m-guihard/relativeGPS/Components/rylr998/RYLR998.stp

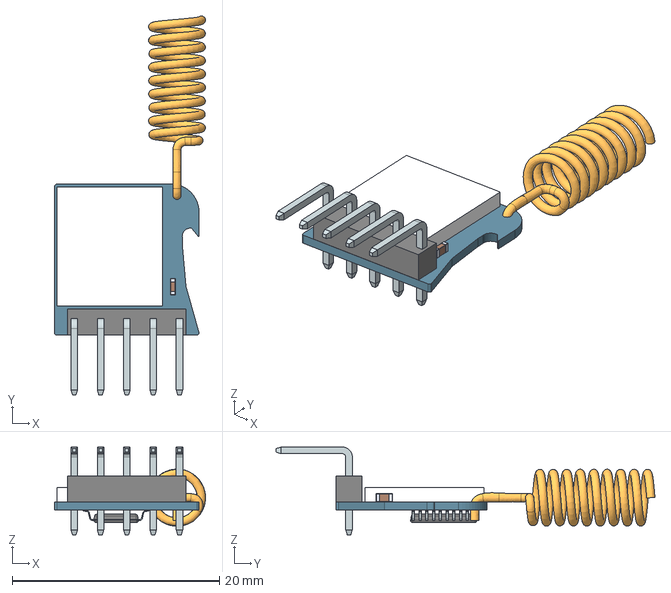
[picture p1: CAD file, 2024-04-07]
Components/rylr998/RYLR998.stp
14.6 x 36.6 x 8.49 mm
