m-guihard/relativeGPS/PCB/relativeGPS.kicad_pcb

## KiCad design PCB/relativeGPS.kicad_pcb (2025-03-02)

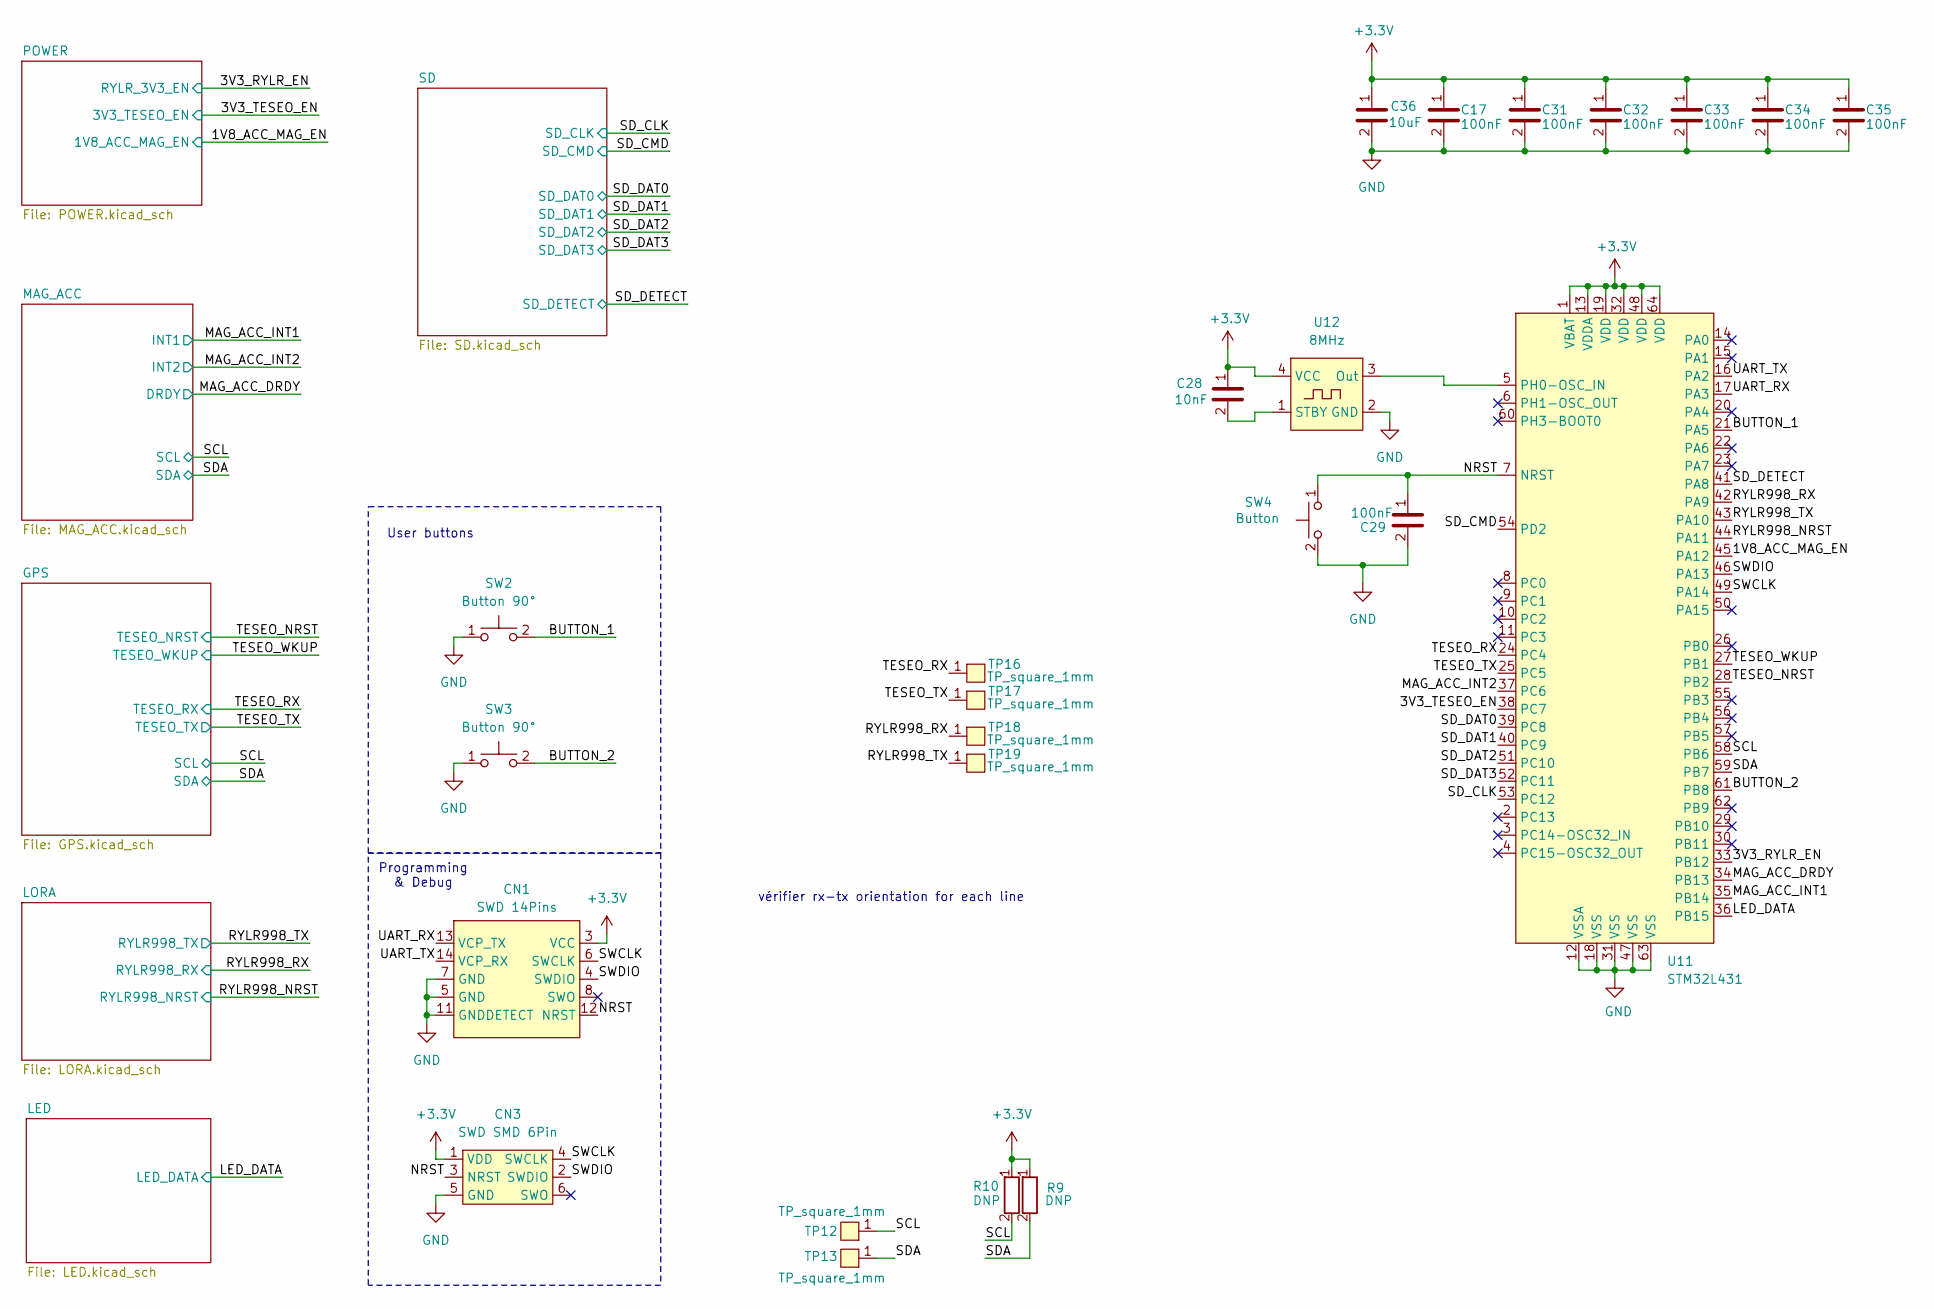
[picture p2: schematic relativeGPS.kicad_sch]

Parts:
C17, C29, C31, C32, C33, C34, C35: C_100nF_50V_10%_X7R_0402_H0.55; C_0402_H0.55; Manufacturer P/N GRM155R71H104KE14J; Digikey P/N 490-13342-1-ND
C28: C_10nF_50V_10%_X7R_0402_H0.55; C_0402_H0.55; Manufacturer P/N CGA2B3X7R1H103K050BE; Digikey P/N 445-173650-1-ND
C36: C_10uF_10V_20%_X5R_0402_H0.55; C_0402_H0.55; Manufacturer P/N GRM155R61A106ME11D; Digikey P/N 490-GRM155R61A106ME11DCT-ND
CN1: FTSH-107-01-L-DV-K-P-TR; Manufacturer P/N FTSH-107-01-L-DV-K-P-TR; Digikey P/N SAM13946CT-ND
CN3: TC2030-IDC; Debug_pads_6pin
R9, R10: R_DNP_0402; R_0402_H0.4
SW2, SW3: EVQ-P7A01P; Manufacturer P/N EVQ-P7A01P; Digikey P/N P16763CT-ND
SW4: TL3315NF160Q; Manufacturer P/N TL3315NF160Q; Digikey P/N EG4621CT-ND
TP12, TP13, TP16, TP17, TP18, TP19: TP_square_1mm; Testpoint_square_1mm
U11: STM32L431RCT6TR; LQFP-64_10x10mm_P0.5mm; Manufacturer P/N STM32L431RCT6TR; Digikey P/N 497-STM32L431RCT6CT-ND
U12: ASE-8.000MHZ-L-C-T; Manufacturer P/N ASE-8.000MHZ-L-C-T; Digikey P/N 535-ASE-8.000MHZ-L-C-TCT-ND

Connections:
+3.3V: C17.1, C28.1, C31.1, C32.1, C33.1, C34.1, C35.1, C36.1, CN1.3 (VCC), CN3.1 (VDD), R9.1, R10.1, U11.1 (VBAT), U11.13 (VDDA), U11.19 (VDD), U11.32 (VDD), U11.48 (VDD), U11.64 (VDD), U12.4 (VCC); also elsewhere on the board
/1V8_ACC_MAG_EN: U11.45 (PA12); also elsewhere on the board
/3V3_RYLR_EN: U11.33 (PB12); also elsewhere on the board
/3V3_TESEO_EN: U11.38 (PC7); also elsewhere on the board
/BUTTON_1: SW2.2, U11.21 (PA5)
/BUTTON_2: SW3.2, U11.61 (PB8)
/LED_DATA: U11.36 (PB15); also elsewhere on the board
/MAG_ACC_DRDY: U11.34 (PB13); also elsewhere on the board
/MAG_ACC_INT1: U11.35 (PB14); also elsewhere on the board
/MAG_ACC_INT2: U11.37 (PC6); also elsewhere on the board
/NRST: C29.1, CN1.12 (NRST), CN3.3 (NRST), SW4.1, U11.7 (NRST)
/RYLR998_NRST: U11.44 (PA11); also elsewhere on the board
/RYLR998_RX: TP18.1, U11.42 (PA9); also elsewhere on the board
/RYLR998_TX: TP19.1, U11.43 (PA10); also elsewhere on the board
/SCL: R10.2, TP12.1, U11.58 (PB6); also elsewhere on the board
/SDA: R9.2, TP13.1, U11.59 (PB7); also elsewhere on the board
/SD_CLK: U11.53 (PC12); also elsewhere on the board
/SD_CMD: U11.54 (PD2); also elsewhere on the board
/SD_DAT0: U11.39 (PC8); also elsewhere on the board
/SD_DAT1: U11.40 (PC9); also elsewhere on the board
/SD_DAT2: U11.51 (PC10); also elsewhere on the board
/SD_DAT3: U11.52 (PC11); also elsewhere on the board
/SD_DETECT: U11.41 (PA8); also elsewhere on the board
/SWCLK: CN1.6 (SWCLK), CN3.4 (SWCLK), U11.49 (PA14)
/SWDIO: CN1.4 (SWDIO), CN3.2 (SWDIO), U11.46 (PA13)
/TESEO_NRST: U11.28 (PB2); also elsewhere on the board
/TESEO_RX: TP16.1, U11.24 (PC4); also elsewhere on the board
/TESEO_TX: TP17.1, U11.25 (PC5); also elsewhere on the board
/TESEO_WKUP: U11.27 (PB1); also elsewhere on the board
/UART_RX: CN1.13 (VCP_TX), U11.17 (PA3)
/UART_TX: CN1.14 (VCP_RX), U11.16 (PA2)
GND: C17.2, C29.2, C31.2, C32.2, C33.2, C34.2, C35.2, C36.2, CN1.5 (GND), CN1.7 (GND), CN1.11 (GNDDETECT), CN3.5 (GND), SW2.1, SW3.1, SW4.2, U11.12 (VSSA), U11.18 (VSS), U11.31 (VSS), U11.47 (VSS), U11.63 (VSS), U12.2 (GND); also elsewhere on the board
unnamed: U11.5 (PH0-OSC_IN), U12.3 (Out)
unnamed: C28.2, U12.1 (STBY)

Notes on the sheet:
Programming & Debug
vérifier rx-tx orientation for each line
User buttons

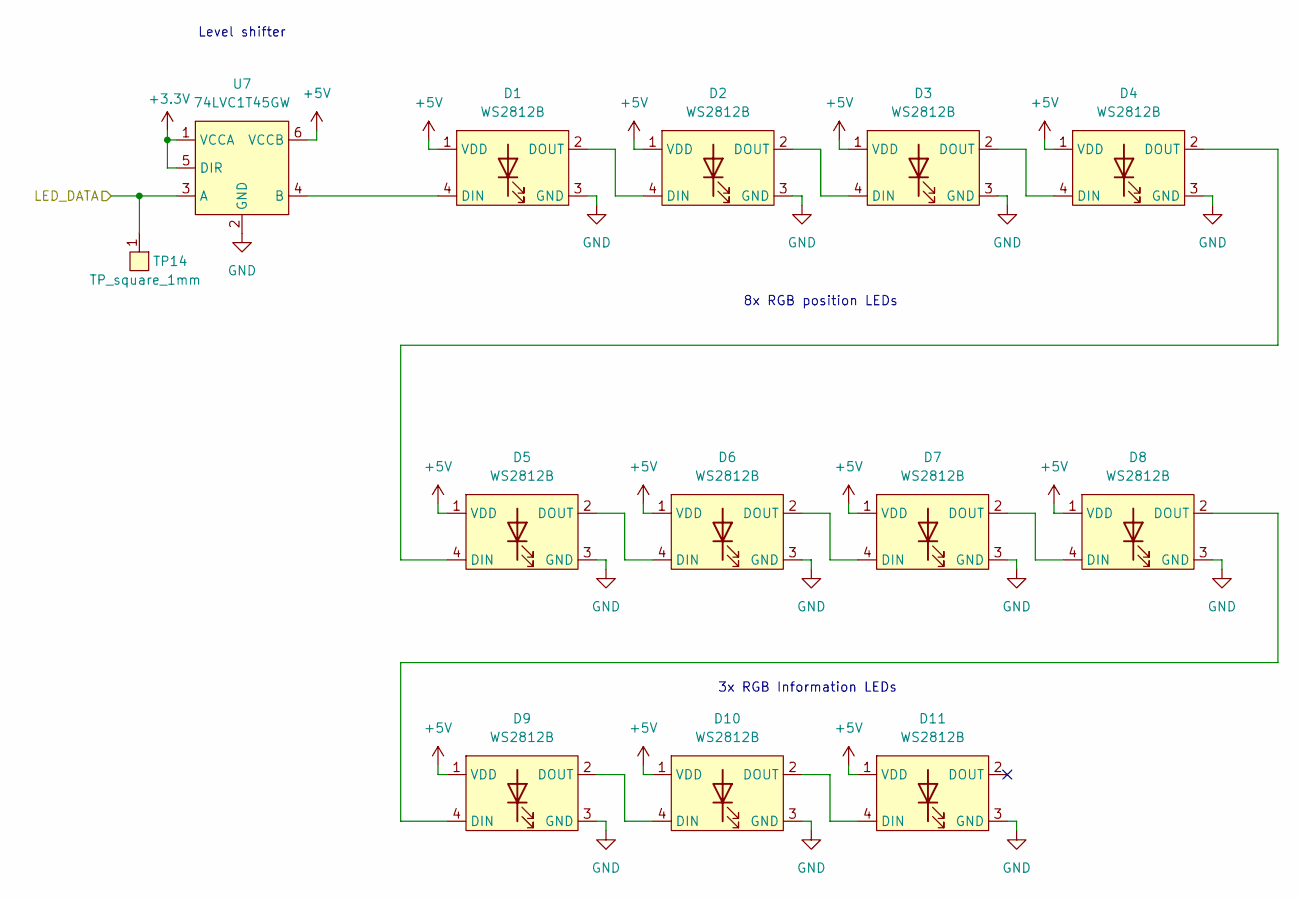
[picture p3: schematic LED.kicad_sch]

Parts:
D1, D2, D3, D4, D5, D6, D7, D8, D9, D10, D11: COM-16347; Manufacturer P/N COM-16347; Digikey P/N 1568-COM-16347CT-ND
TP14: TP_square_1mm; Testpoint_square_1mm
U7: 74LVC1T45GW.125; TSSOP6_SOT363-2; Manufacturer P/N 74LVC1T45GW.125; Digikey P/N 1727-4560-1-ND

Connections:
+3.3V: U7.1 (VCCA), U7.5 (DIR); also elsewhere on the board
+5V: D1.1 (VDD), D2.1 (VDD), D3.1 (VDD), D4.1 (VDD), D5.1 (VDD), D6.1 (VDD), D7.1 (VDD), D8.1 (VDD), D9.1 (VDD), D10.1 (VDD), D11.1 (VDD), U7.6 (VCCB); also elsewhere on the board
/LED_DATA: TP14.1, U7.3 (A); also elsewhere on the board
GND: D1.3 (GND), D2.3 (GND), D3.3 (GND), D4.3 (GND), D5.3 (GND), D6.3 (GND), D7.3 (GND), D8.3 (GND), D9.3 (GND), D10.3 (GND), D11.3 (GND), U7.2 (GND); also elsewhere on the board
unnamed: D1.4 (DIN), U7.4 (B)
unnamed: D1.2 (DOUT), D2.4 (DIN)
unnamed: D2.2 (DOUT), D3.4 (DIN)
unnamed: D3.2 (DOUT), D4.4 (DIN)
unnamed: D4.2 (DOUT), D5.4 (DIN)
unnamed: D5.2 (DOUT), D6.4 (DIN)
unnamed: D6.2 (DOUT), D7.4 (DIN)
unnamed: D7.2 (DOUT), D8.4 (DIN)
unnamed: D8.2 (DOUT), D9.4 (DIN)
unnamed: D9.2 (DOUT), D10.4 (DIN)
unnamed: D10.2 (DOUT), D11.4 (DIN)

Notes on the sheet:
3x RGB Information LEDs
Level shifter
8x RGB position LEDs

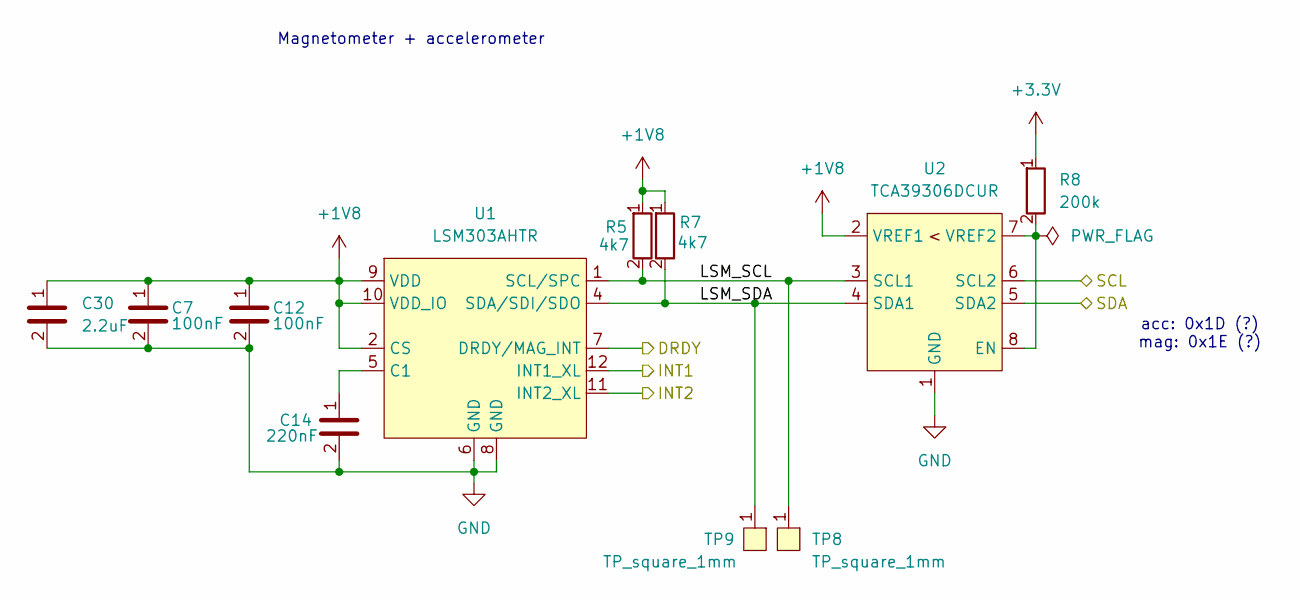
[picture p4: schematic MAG_ACC.kicad_sch]

Parts:
C7, C12: C_100nF_50V_10%_X7R_0402_H0.55; C_0402_H0.55; Manufacturer P/N GRM155R71H104KE14J; Digikey P/N 490-13342-1-ND
C14: C_220nF_16V_10%_X7R_0402_H0.55; C_0402_H0.55; Manufacturer P/N GCM155R71C224KE02D; Digikey P/N 490-10671-1-ND
C30: C_2.2uF_25V_25%_X5R_0402_H0.55; C_0402_H0.55; Manufacturer P/N GRM155R61E225ME15D; Digikey P/N 490-10457-1-ND
R5, R7: R_4k7_5%_1/16W_0402; R_0402_H0.4; Manufacturer P/N RC0402JR-074K7P; Digikey P/N YAG1287CT-ND
R8: R_200k_1%_1/16W_0402; R_0402_H0.4; Manufacturer P/N RC0402FR-13200KL; Digikey P/N 13-RC0402FR-13200KLCT-ND
TP8, TP9: TP_square_1mm; Testpoint_square_1mm
U1: LSM303AH; LSM303AHTR; Manufacturer P/N LSM303AHTR; Digikey P/N 497-17053-1-ND
U2: TCA39306DCUR; Manufacturer P/N TCA39306DCUR; Digikey P/N 296-TCA39306DCURCT-ND

Connections:
+1V8: C7.1, C12.1, C30.1, R5.1, R7.1, U1.2 (CS), U1.9 (VDD), U1.10 (VDD_IO), U2.2 (VREF1); also elsewhere on the board
+3.3V: R8.1; also elsewhere on the board
/MAG_ACC/LSM_SCL: R5.2, TP8.1, U1.1 (SCL/SPC), U2.3 (SCL1)
/MAG_ACC/LSM_SDA: R7.2, TP9.1, U1.4 (SDA/SDI/SDO), U2.4 (SDA1)
/MAG_ACC_DRDY: U1.7 (DRDY/MAG_INT); also elsewhere on the board
/MAG_ACC_INT1: U1.12 (INT1_XL); also elsewhere on the board
/MAG_ACC_INT2: U1.11 (INT2_XL); also elsewhere on the board
/SCL: U2.6 (SCL2); also elsewhere on the board
/SDA: U2.5 (SDA2); also elsewhere on the board
GND: C7.2, C12.2, C14.2, C30.2, U1.6 (GND), U1.8 (GND), U2.1 (GND); also elsewhere on the board
unnamed: C14.1, U1.5 (C1)
unnamed: R8.2, U2.7 (VREF2), U2.8 (EN)

Notes on the sheet:
Magnetometer + accelerometer
acc: 0x1D (?) mag: 0x1E (?)

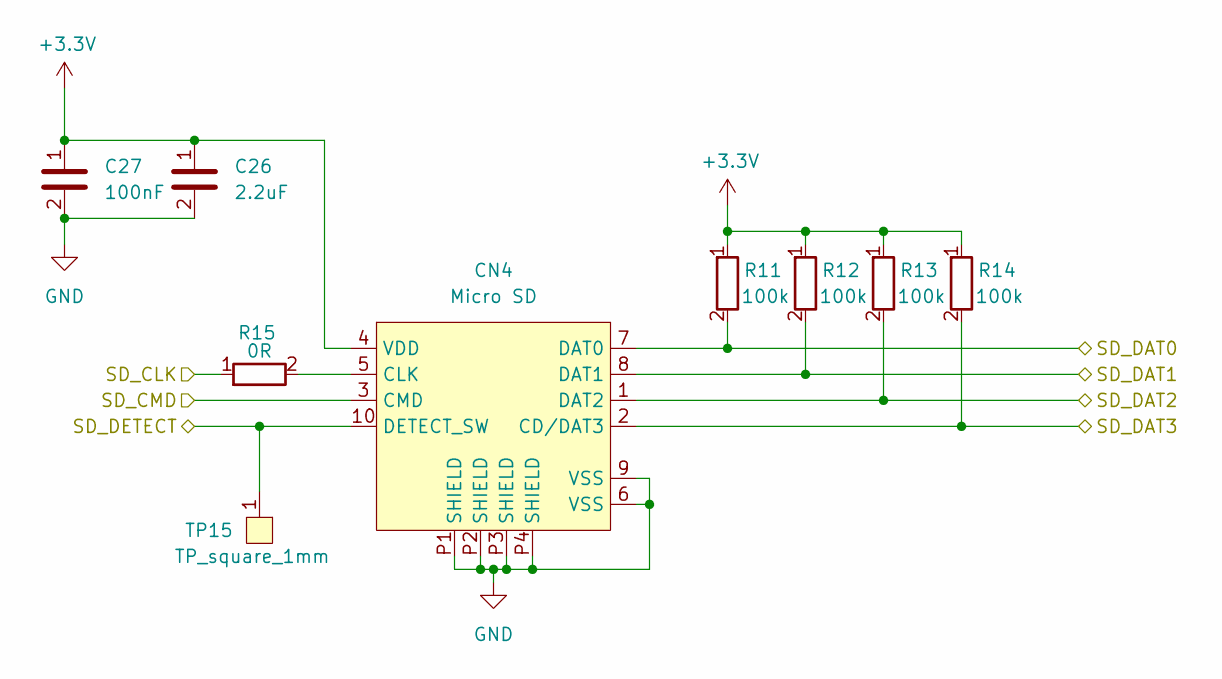
[picture p5: schematic SD.kicad_sch]

Parts:
C26: C_2.2uF_25V_25%_X5R_0402_H0.55; C_0402_H0.55; Manufacturer P/N GRM155R61E225ME15D; Digikey P/N 490-10457-1-ND
C27: C_100nF_50V_10%_X7R_0402_H0.55; C_0402_H0.55; Manufacturer P/N GRM155R71H104KE14J; Digikey P/N 490-13342-1-ND
CN4: 5033981892; Micro_SD_5033981892; Manufacturer P/N 5033981892; Digikey P/N WM11190CT-ND
R11, R12, R13, R14: R_100k_1%_1/16W_0402; R_0402_H0.4; Manufacturer P/N RC0402FR-07100KL; Digikey P/N 311-100KLRCT-ND
R15: R_0R_1%_1/16W_0402; R_0402_H0.4; Manufacturer P/N AC0402FR-070RL; Digikey P/N 13-AC0402FR-070RLCT-ND
TP15: TP_square_1mm; Testpoint_square_1mm

Connections:
+3.3V: C26.1, C27.1, CN4.4 (VDD), R11.1, R12.1, R13.1, R14.1; also elsewhere on the board
/SD_CLK: R15.1; also elsewhere on the board
/SD_CMD: CN4.3 (CMD); also elsewhere on the board
/SD_DAT0: CN4.7 (DAT0), R11.2; also elsewhere on the board
/SD_DAT1: CN4.8 (DAT1), R12.2; also elsewhere on the board
/SD_DAT2: CN4.1 (DAT2), R13.2; also elsewhere on the board
/SD_DAT3: CN4.2 (CD/DAT3), R14.2; also elsewhere on the board
/SD_DETECT: CN4.10 (DETECT_SW), TP15.1; also elsewhere on the board
GND: C26.2, C27.2, CN4.6 (VSS), CN4.9 (VSS), CN4.P1 (SHIELD), CN4.P2 (SHIELD), CN4.P3 (SHIELD), CN4.P4 (SHIELD); also elsewhere on the board
unnamed: CN4.5 (CLK), R15.2

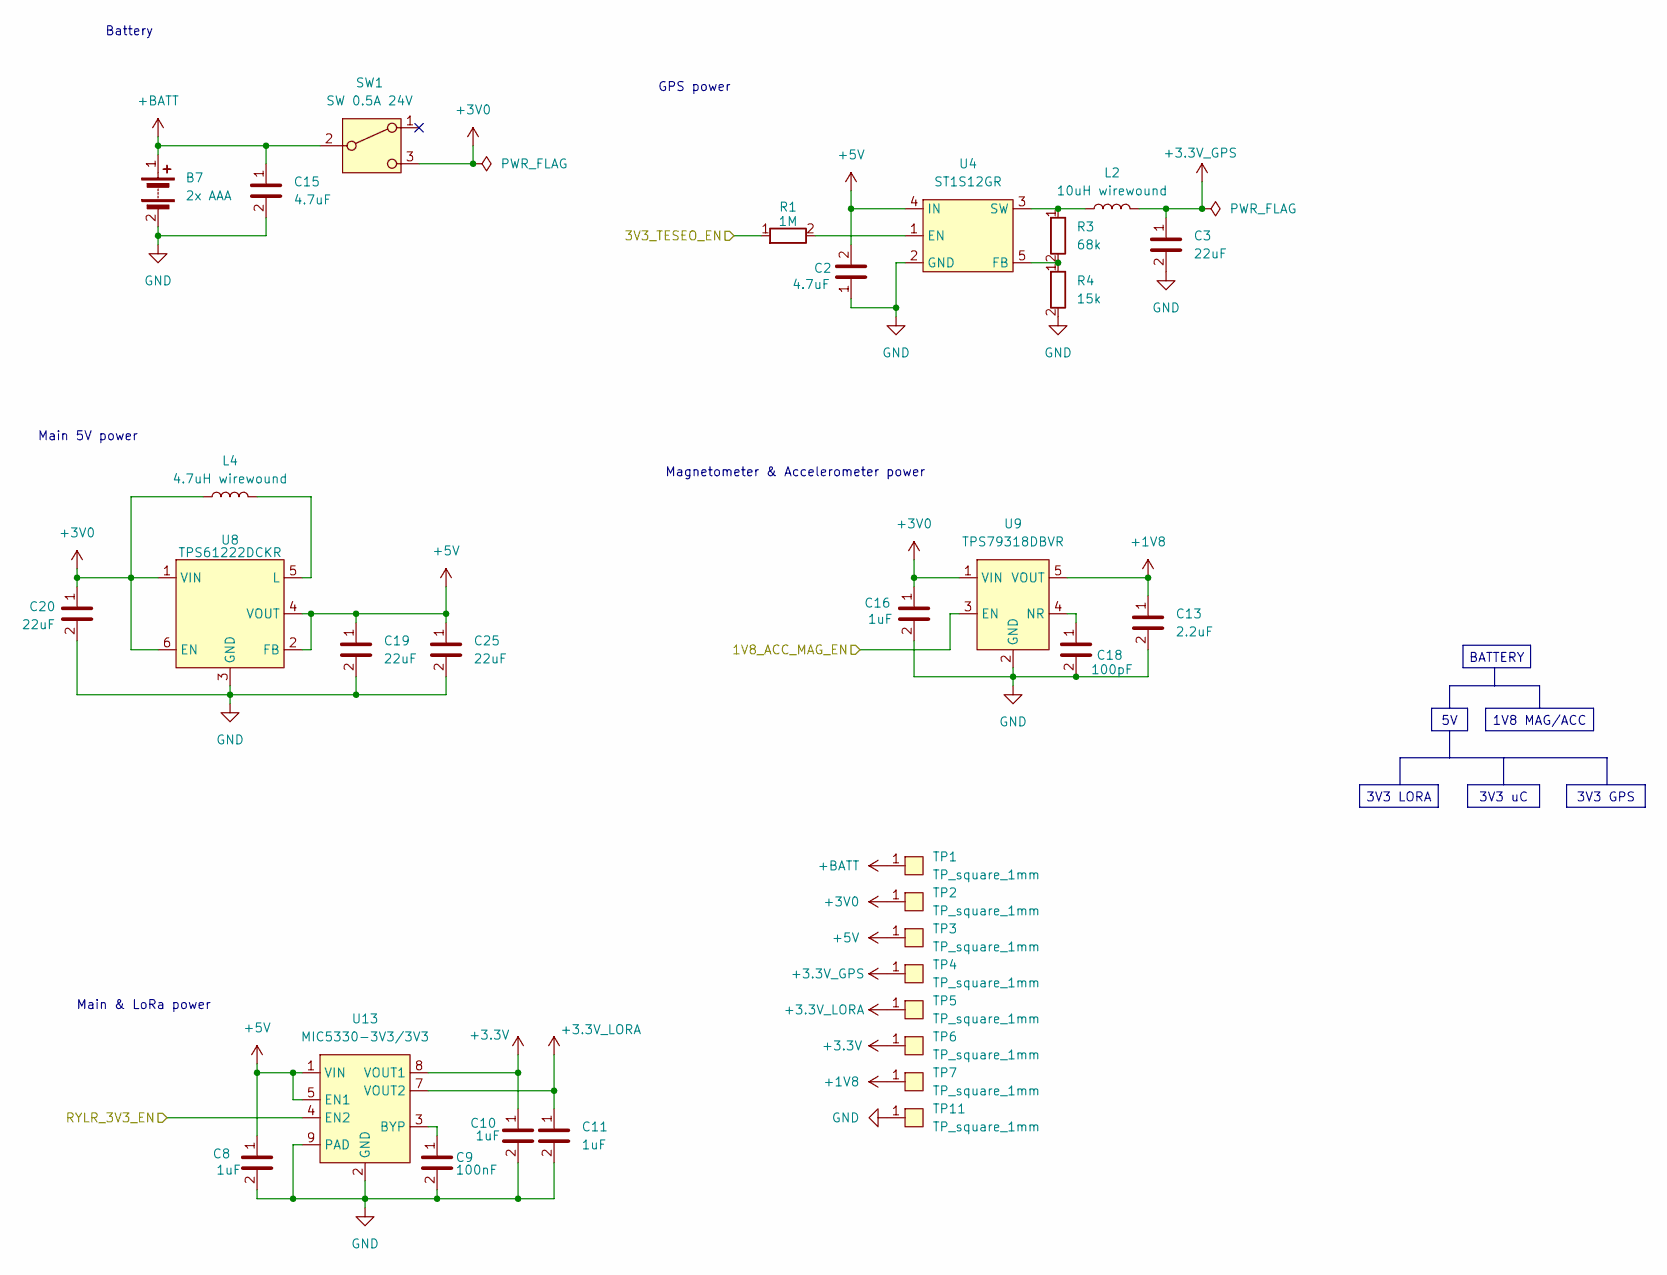
[picture p6: schematic POWER.kicad_sch]

Parts:
B7: AAA_2X_Holder; Manufacturer P/N 2468; Digikey P/N 36-2468-ND
C2, C15: C_4.7uF_10V_10%_X7S_0603_H0.95; C_0603_H0.95; Manufacturer P/N GRM188C71A475KE11D; Digikey P/N 490-11992-1-ND
C3: C_22uF_6.3V_20%_X5R_0805_H1.4; C_0805_H1.4; Manufacturer P/N C0805C226M9PAC7800; Digikey P/N 399-C0805C226M9PAC7800CT-ND
C8, C10, C11: C_1uF_50V_10%_X5R_0402_H0.55; C_0402_H0.55; Manufacturer P/N GRM155R61H105KE05D; Digikey P/N 490-GRM155R61H105KE05DCT-ND
C9: C_100nF_50V_10%_X7R_0402_H0.55; C_0402_H0.55; Manufacturer P/N GRM155R71H104KE14J; Digikey P/N 490-13342-1-ND
C13: C_2.2uF_25V_25%_X5R_0402_H0.55; C_0402_H0.55; Manufacturer P/N GRM155R61E225ME15D; Digikey P/N 490-10457-1-ND
C16: C_1uF_50V_10%_X5R_0603_H0.9; C_0603_H0.95; Manufacturer P/N GRT188R61H105KE13D; Digikey P/N 490-12330-1-ND
C18: C_100pF_50V_5%_C0G_0603_H0.9; C_0603_H0.95; Manufacturer P/N GRM1885C1H101JA01D; Digikey P/N 490-1427-1-ND
C19, C20, C25: C_22uF_25V_20%_X5S_0603_H1; C_0603_H0.95; Manufacturer P/N GRM188C61E226ME01J; Digikey P/N 490-GRM188C61E226ME01JCT-ND
L2: L_10uH_20%_1.51A_160mOhm; LTF5022T-100M1R3-D; Manufacturer P/N LTF5022T-100M1R3-D; Digikey P/N 445-16215-1-ND
L4: L_4.7uH_20%_1.7A_120mOhm; LQH3NPZ4R7MMEL; Manufacturer P/N LQH3NPZ4R7MMEL; Digikey P/N 490-LQH3NPZ4R7MMELCT-ND
R1: R_1M_5%_1/16W_0402; R_0402_H0.4; Manufacturer P/N RC0402JR-071ML; Digikey P/N 311-1.0MJRCT-ND
R3: R_68k_1%_1/16W_0402; R_0402_H0.4; Manufacturer P/N AC0402FR-0768KL; Digikey P/N YAG3506CT-ND
R4: R_15k_1%_1/16W_0402; R_0402_H0.4; Manufacturer P/N RC0402FR-1315KL; Digikey P/N 13-RC0402FR-1315KLCT-ND
SW1: switch_slide_2pos; 09.10290.01; Manufacturer P/N 09.10290.01; Digikey P/N 1948-1089-ND
TP1, TP2, TP3, TP4, TP5, TP6, TP7, TP11: TP_square_1mm; Testpoint_square_1mm
U4: ST1S12GR; Manufacturer P/N ST1S12GR; Digikey P/N 497-6906-1-ND
U8: TPS61222DCKR; Manufacturer P/N TPS61222DCKR; Digikey P/N 296-39435-1-ND
U9: TPS79318DBVR; Manufacturer P/N TPS79318DBVR; Digikey P/N 296-12155-1-ND
U13: MIC5330-SSYML-TR; MIC5330; Manufacturer P/N MIC5330-SSYML-TR; Digikey P/N 576-1947-1-ND

Connections:
+1V8: C13.1, TP7.1, U9.5 (VOUT); also elsewhere on the board
+3.3V: C10.1, TP6.1, U13.8 (VOUT1); also elsewhere on the board
+3.3V_GPS: C3.1, L2.2, TP4.1; also elsewhere on the board
+3.3V_LORA: C11.1, TP5.1, U13.7 (VOUT2); also elsewhere on the board
+3V0: C16.1, C20.1, L4.1, SW1.3, TP2.1, U8.1 (VIN), U8.6 (EN), U9.1 (VIN)
+5V: C2.2, C8.1, C19.1, C25.1, TP3.1, U4.4 (IN), U8.2 (FB), U8.4 (VOUT), U13.1 (VIN), U13.5 (EN1); also elsewhere on the board
+BATT: B7.1, C15.1, SW1.2, TP1.1
/1V8_ACC_MAG_EN: U9.3 (EN); also elsewhere on the board
/3V3_RYLR_EN: U13.4 (EN2); also elsewhere on the board
/3V3_TESEO_EN: R1.1; also elsewhere on the board
GND: B7.2, C2.1, C3.2, C8.2, C9.2, C10.2, C11.2, C13.2, C15.2, C16.2, C18.2, C19.2, C20.2, C25.2, R4.2, TP11.1, U4.2 (GND), U8.3 (GND), U9.2 (GND), U13.2 (GND), U13.9 (PAD); also elsewhere on the board
unnamed: R1.2, U4.1 (EN)
unnamed: R3.2, R4.1, U4.5 (FB)
unnamed: L2.1, R3.1, U4.3 (SW)
unnamed: L4.2, U8.5 (L)
unnamed: C18.1, U9.4 (NR)
unnamed: C9.1, U13.3 (BYP)

Notes on the sheet:
Magnetometer & Accelerometer power
Main & LoRa power
Main 5V power
GPS power
Battery
3V3 LORA
3V3 uC
BATTERY
1V8 MAG/ACC
3V3 GPS

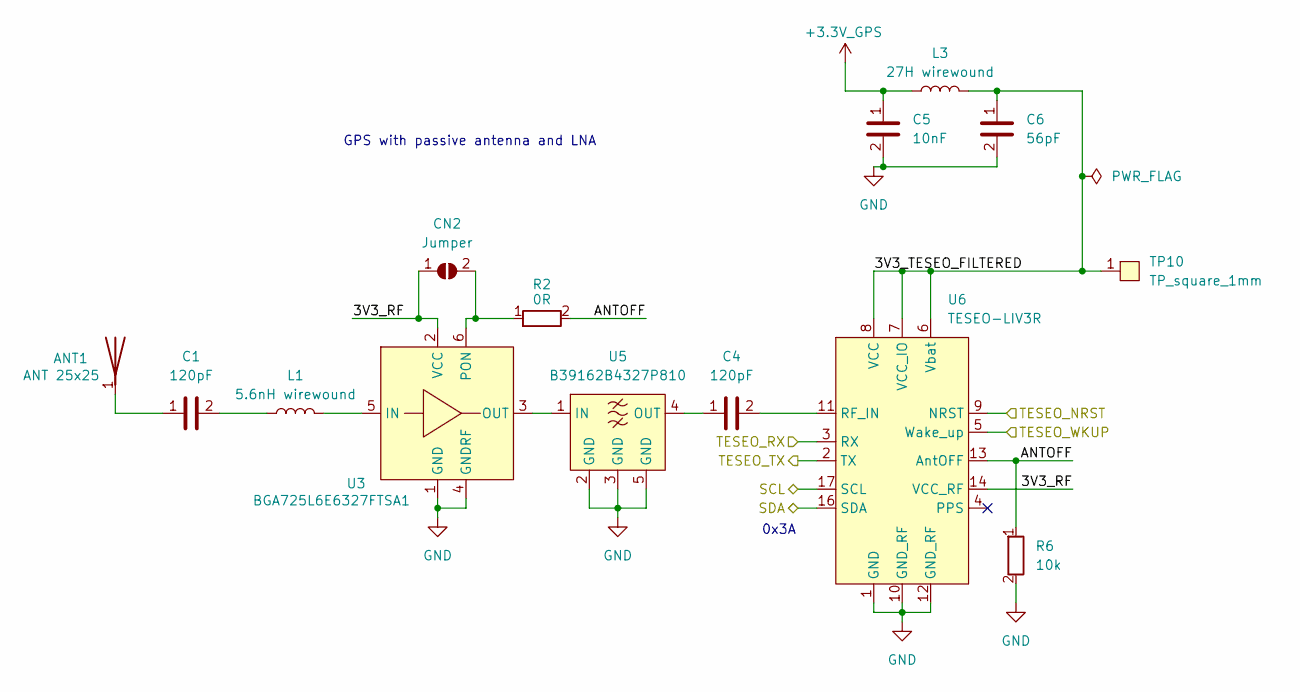
[picture p7: schematic GPS.kicad_sch]

Parts:
ANT1: ANT2525B00DT1516S; Manufacturer P/N ANT2525B00DT1516S; Digikey P/N 311-1539-ND
C1, C4: C_120pF_50V_5%_C0G_0402_H0.55; C_0402_H0.55; Manufacturer P/N GCM1555C1H121JA16D; Digikey P/N 490-13287-1-ND
C5: C_10nF_50V_10%_X7R_0402_H0.55; C_0402_H0.55; Manufacturer P/N CGA2B3X7R1H103K050BE; Digikey P/N 445-173650-1-ND
C6: C_56pF_50V_2%_C0G_0201_H0.33; C_0402_H0.55; Manufacturer P/N GRM0335C1H560GA01D; Digikey P/N 490-13329-1-ND
CN2: Solder_Jumper-2_Open; SolderJumper-2_Open
L1: L_5.6nH_2%_1.77A_40mOhm; LQW15AN5N6G80D; Manufacturer P/N LQW15AN5N6G80D; Digikey P/N 490-LQW15AN5N6G80DCT-ND
L3: L_27nH_5%_0.35A_460mOhm; LQG15HS27NJ02D; Manufacturer P/N LQG15HS27NJ02D; Digikey P/N 490-2628-1-ND
R2: R_0R_0603; R_0603_H0.55; Manufacturer P/N RC0603JR-070RL; Digikey P/N 311-0.0GRCT-ND
R6: R_10k_5%_1/16W_0402; R_0402_H0.4; Manufacturer P/N RC0402JR-0710KP; Digikey P/N YAG1281CT-ND
TP10: TP_square_1mm; Testpoint_square_1mm
U3: BGA725L6E6327FTSA1; Manufacturer P/N BGA725L6E6327FTSA1; Digikey P/N BGA725L6E6327FTSA1CT-ND
U5: B39162B4327P810; Manufacturer P/N B39162B4327P810; Digikey P/N 495-7424-1-ND
U6: TESEO-LIV3R; Manufacturer P/N TESEO-LIV3R; Digikey P/N 497-19468-1-ND

Connections:
+3.3V_GPS: C5.1, L3.1; also elsewhere on the board
/GPS/3V3_RF: CN2.1, U3.2 (VCC), U6.14 (VCC_RF)
/GPS/3V3_TESEO_FILTERED: C6.1, L3.2, TP10.1, U6.6 (Vbat), U6.7 (VCC_IO), U6.8 (VCC)
/GPS/ANTOFF: R2.2, R6.1, U6.13 (AntOFF)
/SCL: U6.17 (SCL); also elsewhere on the board
/SDA: U6.16 (SDA); also elsewhere on the board
/TESEO_NRST: U6.9 (NRST); also elsewhere on the board
/TESEO_RX: U6.3 (RX); also elsewhere on the board
/TESEO_TX: U6.2 (TX); also elsewhere on the board
/TESEO_WKUP: U6.5 (Wake_up); also elsewhere on the board
GND: C5.2, C6.2, R6.2, U3.1 (GND), U3.4 (GNDRF), U5.2 (GND), U5.3 (GND), U5.5 (GND), U6.1 (GND), U6.10 (GND_RF), U6.12 (GND_RF); also elsewhere on the board
unnamed: ANT1.1, C1.1
unnamed: C1.2, L1.1
unnamed: L1.2, U3.5 (IN)
unnamed: U3.3 (OUT), U5.1 (IN)
unnamed: CN2.2, R2.1, U3.6 (PON)
unnamed: C4.1, U5.4 (OUT)
unnamed: C4.2, U6.11 (RF_IN)

Notes on the sheet:
GPS with passive antenna and LNA
0x3A

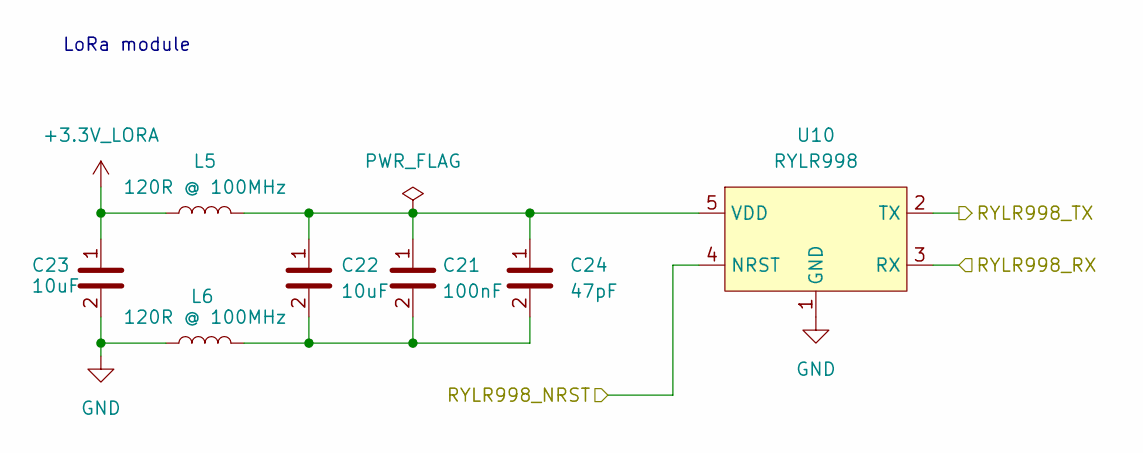
[picture p8: schematic LORA.kicad_sch]

Parts:
C21: C_100nF_50V_10%_X7R_0402_H0.55; C_0402_H0.55; Manufacturer P/N GRM155R71H104KE14J; Digikey P/N 490-13342-1-ND
C22, C23: C_10uF_10V_20%_X5R_0603H0.9; C_0603_H0.95; Manufacturer P/N GRM188R61A106ME69D; Digikey P/N 490-10475-1-ND
C24: C_47pF_50V_5%_C0G_0402; C_0402_H0.55; Manufacturer P/N GRM1555C1H470JA01D; Digikey P/N 490-5942-1-ND
L5, L6: FERR_120R@100MHz_5%_1.5A_95mOhm; FERR_0402_H0.55; Manufacturer P/N BLM15EG121SN1D; Digikey P/N 490-4004-1-ND
U10: RYLR998; RYLR998_flat; Manufacturer P/N RYLR998

Connections:
+3.3V_LORA: C23.1, L5.1; also elsewhere on the board
/RYLR998_NRST: U10.4 (NRST); also elsewhere on the board
/RYLR998_RX: U10.3 (RX); also elsewhere on the board
/RYLR998_TX: U10.2 (TX); also elsewhere on the board
GND: C23.2, L6.1, U10.1 (GND); also elsewhere on the board
unnamed: C21.2, C22.2, C24.2, L6.2
unnamed: C21.1, C22.1, C24.1, L5.2, U10.5 (VDD)

Notes on the sheet:
LoRa module

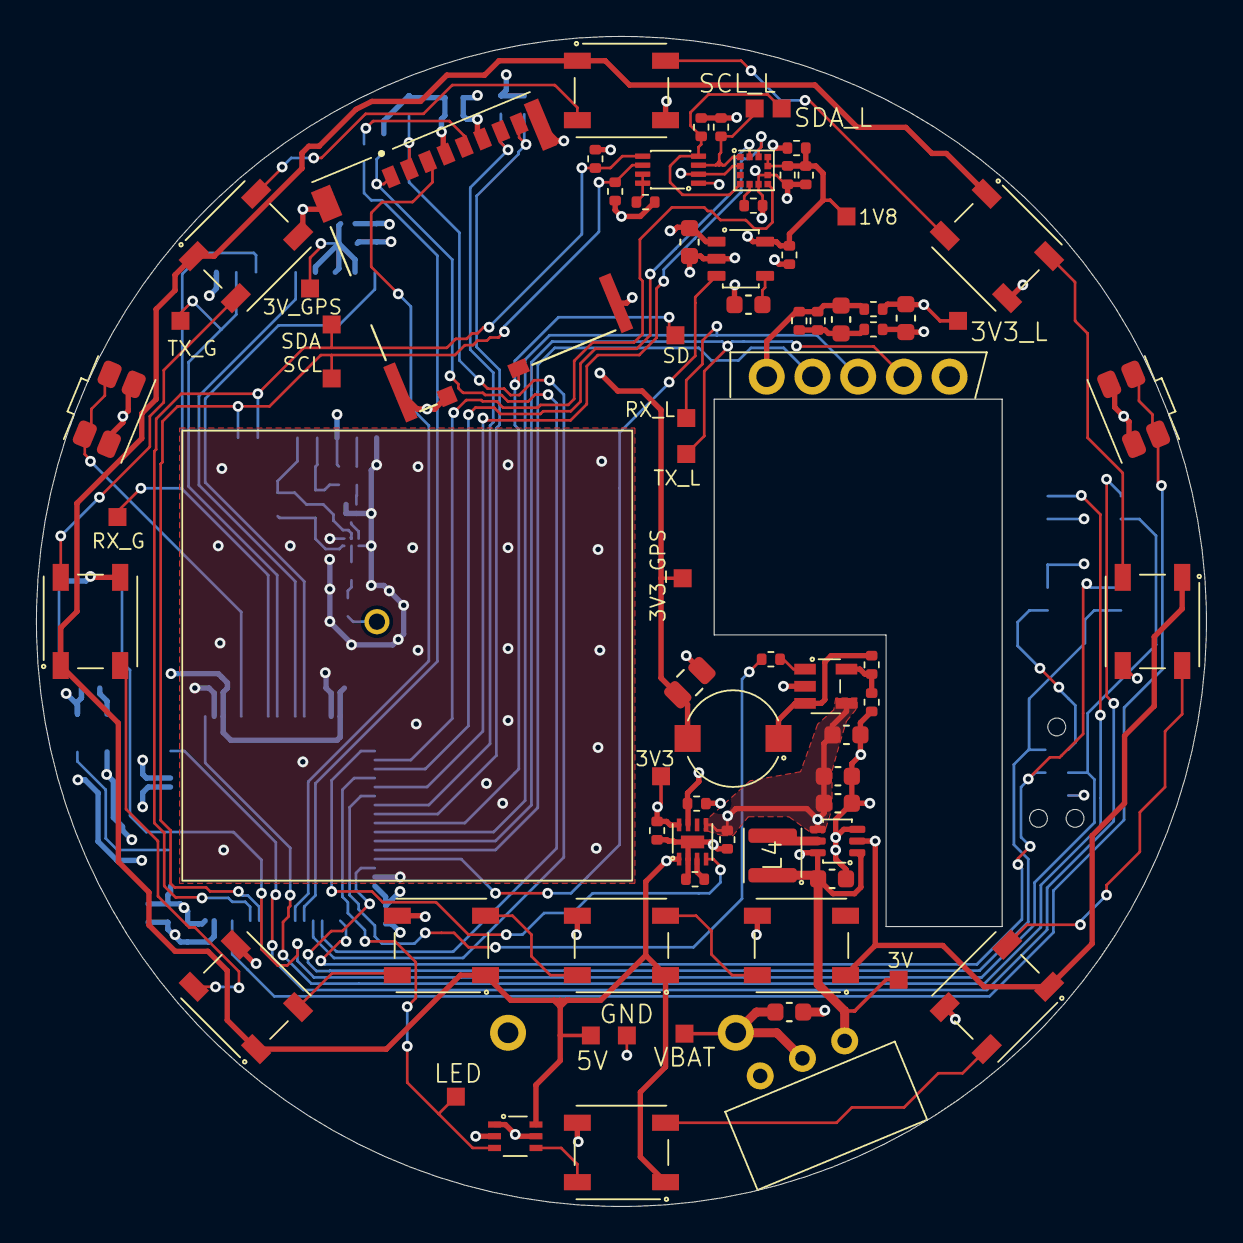
[picture p9: board relativeGPS.kicad_pcb from above]

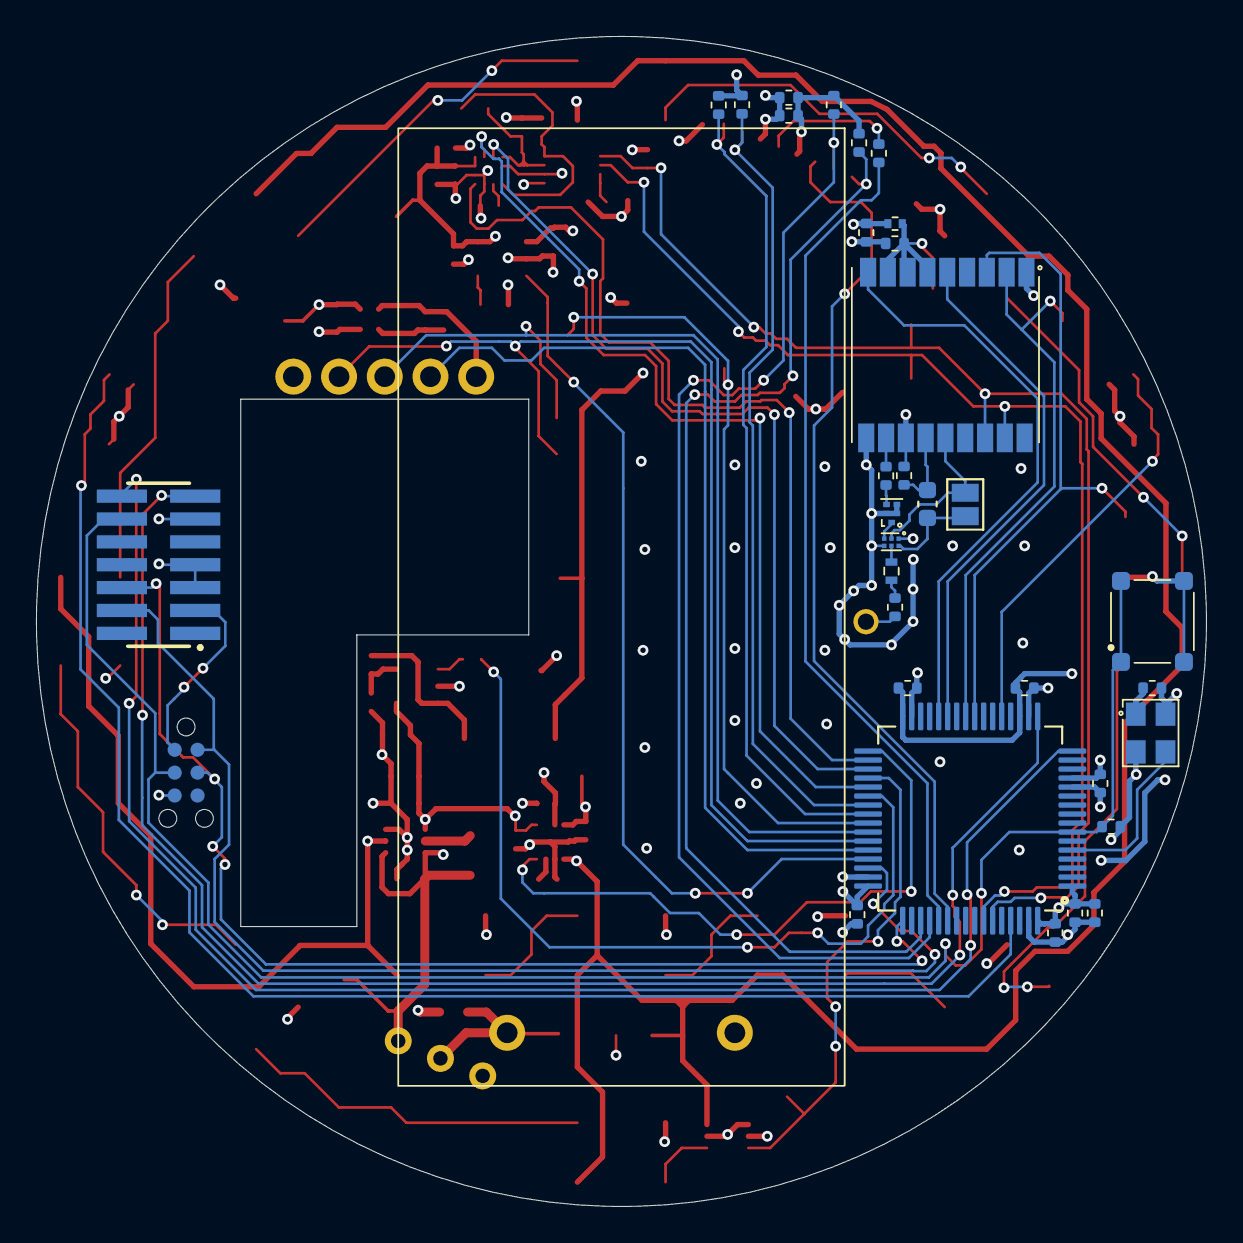
[picture p10: board relativeGPS.kicad_pcb from below]

Board: 4 copper layers, 65.0 x 65.0 mm, 110 parts (34 on the bottom side), 74 nets.
