m-guihard/relativeGPS/firmware/relativeGPS.ioc

Mcu.UserName=STM32L431RCTx
PA10.Signal=USART1_RX
PA2.Signal=USART2_TX
PA3.Signal=USART2_RX
PA5.GPIO_Label=BUTTON1
PA5.Signal=GPIO_Input
PA8.GPIO_Label=SD_DETECT
PA8.Signal=GPIO_Input
PA9.Signal=USART1_TX
PB15.GPIO_Label=LED_CHAIN
PB15.Signal=S_TIM15_CH2
PB6.Signal=I2C1_SCL
PB7.Signal=I2C1_SDA
PB8.GPIO_Label=BUTTON2
PB8.Signal=GPIO_Input
PC10.Signal=SDMMC1_D2
PC11.Signal=SDMMC1_D3
PC12.Signal=SDMMC1_CK
PC4.Signal=USART3_TX
PC5.Signal=USART3_RX
PC7.GPIO_Label=TESEO_3V3_EN
PC7.Signal=GPIO_Output
PC8.Signal=SDMMC1_D0
PC9.Signal=SDMMC1_D1
PD2.Signal=SDMMC1_CMD
