m-guihard/relativeGPS/(commit log)

2024-04-07 Setup project
    [RYLR998.stp, relativeGPS.kicad_pcb, relativeGPS.kicad_sch]
2024-05-16 Remove useless backup files
    [relativeGPS.kicad_sch]
2024-10-02 Add LEDs
    [GPS.kicad_sch, LED.kicad_sch, LORA.kicad_sch, MAG_ACC.kicad_sch, POWER.kicad_sch, relativeGPS.kicad_pcb, relativeGPS.kicad_sch]
2024-10-07 Add TP & level shifter
    [GPS.kicad_sch, LED.kicad_sch, LORA.kicad_sch, MAG_ACC.kicad_sch, POWER.kicad_sch, relativeGPS.kicad_sch]
2024-10-09 Finish schematic minus mcu
    [GPS.kicad_sch, LED.kicad_sch, LORA.kicad_sch, MAG_ACC.kicad_sch, POWER.kicad_sch, SD.kicad_sch, relativeGPS.kicad_sch]
2024-11-24 Layout start
    [BOM.csv, GPS.kicad_sch, LED.kicad_sch, LORA.kicad_sch, MAG_ACC.kicad_sch, POWER.kicad_sch, SD.kicad_sch, relativeGPS.kicad_pcb]
2024-11-30 First layout draft
    [BOM.csv, GPS.kicad_sch, LED.kicad_sch, LORA.kicad_sch, MAG_ACC.kicad_sch, POWER.kicad_sch, SD.kicad_sch, relativeGPS.kicad_pcb]
2025-02-22 Add TPs
    [BOM_old.csv, GPS.kicad_sch, LED.kicad_sch, LORA.kicad_sch, MAG_ACC.kicad_sch, POWER.kicad_sch, SD.kicad_sch, relativeGPS.kicad_pcb]
2025-02-24 Start placing TPs
    [relativeGPS.kicad_pcb]
2025-02-26 Finish pcb?
    [relativeGPS-B_Cu.gbr, relativeGPS-B_Mask.gbr, relativeGPS-B_Paste.gbr, relativeGPS-B_Silkscreen.gbr, relativeGPS-Edge_Cuts.gbr, relativeGPS-F_Cu.gbr, relativeGPS-F_Mask.gbr, relativeGPS-F_Paste.gbr]
2025-02-26 First order
    [relativeGPS-B_Cu.gbr, relativeGPS-B_Mask.gbr, relativeGPS-B_Paste.gbr, relativeGPS-B_Silkscreen.gbr, relativeGPS-Edge_Cuts.gbr, relativeGPS-F_Cu.gbr, relativeGPS-F_Mask.gbr, relativeGPS-F_Paste.gbr]
2025-02-26 Fix MIC5330 DPN
    [POWER.kicad_sch]
2025-02-26 Regen BOM
    [BOM.csv]
2025-02-27 Replace outdated inductor
    [BOM.csv, POWER.kicad_sch, relativeGPS.kicad_pcb]
2025-03-02 Update missing paste layer
    [relativeGPS-B_Cu.gbr, relativeGPS-B_Mask.gbr, relativeGPS-B_Paste.gbr, relativeGPS-B_Silkscreen.gbr, relativeGPS-Edge_Cuts.gbr, relativeGPS-F_Cu.gbr, relativeGPS-F_Mask.gbr, relativeGPS-F_Paste.gbr]
2025-03-02 Regen gerber zip
2025-03-08 Remove pcb backups
